dhkar/ball-velocity-measurement/README.md

# ball-velocity-measurement
This repo contains the Arduino source code and documentation about Measurement Instrumentation of Ball Velocity Using Photoresistor and Laser Diode
  
This project was built in purpose for one of the assignment in EL3013 Instrumentation System course.

# Project Made By :  
Andhika Rahadian 13218030
